dmarcr1997/SoilSpirit/README.md

# SoilSpirit
Code Repo for Arduino/C code for Autonomous Rover
