dmarcr1997/SoilSpirit/Docs/SoilSpiritProtoFinal.pdf

Untitled Gantt Project | Mar 16, 2025 http://

Project manager
Project dates | Feb 19, 2025 - Mar 8, 2025
Completion | 100%
Tasks | 19
Resources | 0

Name | Begin date | End date
MotorControl System | 2/19/25 | 2/26/25
MotorControl: Suspension | 2/19/25 | 2/21/25
Microcontroller Control of motors | 2/24/25 | 2/25/25
MotorControl: Unit Test | 2/25/25 | 2/26/25
Interface creation | 2/26/25 | 2/26/25
Object Detection | 2/25/25 | 2/27/25
Object detection for ESP32 S3 | 2/25/25 | 2/25/25
HTTP Connection to ESP32 | 2/26/25 | 2/27/25
Object Detection: Test | 2/26/25 | 2/27/25
Rover Control and Drive System | 2/27/25 | 3/3/25
Integrate OD into Motor Control | 2/27/25 | 2/27/25
Start/Stop Commands | 2/28/25 | 2/28/25
Ultra sonic sensor emergency stop | 3/3/25 | 3/3/25
Sensor Fusion | 3/4/25 | 3/5/25
Hopper Design | 2/27/25 | 2/27/25
Hopper Build | 2/28/25 | 3/3/25
Tests | 2/24/25 | 3/7/25
Update Website | 2/20/25 | 3/7/25
Update Brief | 2/19/25 | 3/7/25
Untitled Gantt Project | Mar 16, 2025
Tasks | 2

## Gantt Chart

3

Name | Begin date | End date
MotorControl System | 2/19/25 | 2/26/25
MotorControl: Suspension | 2/19/25 | 2/21/25
Microcontroller Control of motors | 2/24/25 | 2/25/25
MotorControl: Unit Test | 2/25/25 | 2/26/25
Interface creation | 2/26/25 | 2/26/25
Object Detection | 2/25/25 | 2/27/25
Object detection for ESP32 S3 | 2/25/25 | 2/25/25
HTTP Connection to ESP32 | 2/26/25 | 2/27/25
Object Detection: Test | 2/26/25 | 2/27/25
Rover Control and Drive System | 2/27/25 | 3/3/25
Integrate OD into Motor Control | 2/27/25 | 2/27/25
Start/Stop Commands | 2/28/25 | 2/28/25
Ultra sonic sensor emergency stop 3/3/25 | 3/3/25
Sensor Fusion | 3/4/25 | 3/5/25
Hopper Design | 2/27/25 | 2/27/25
Hopper Build | 2/28/25 | 3/3/25
Tests | 2/24/25 | 3/7/25
Update Website | 2/20/25 | 3/7/25
Update Brief | 2/19/25 | 3/7/25
February 2025 | March 2025
19 | 20 | 21 | 24 | 25 | 26 | 27 | 28 | 3 | 4 | 5 | 6 | 7 | 10 | 11 | 12 | 13 | 14

Object Detection: Test

## Resources Chart

4
