dmarcr1997/SoilSpirit/Docs/SIPCircuitDesign.png

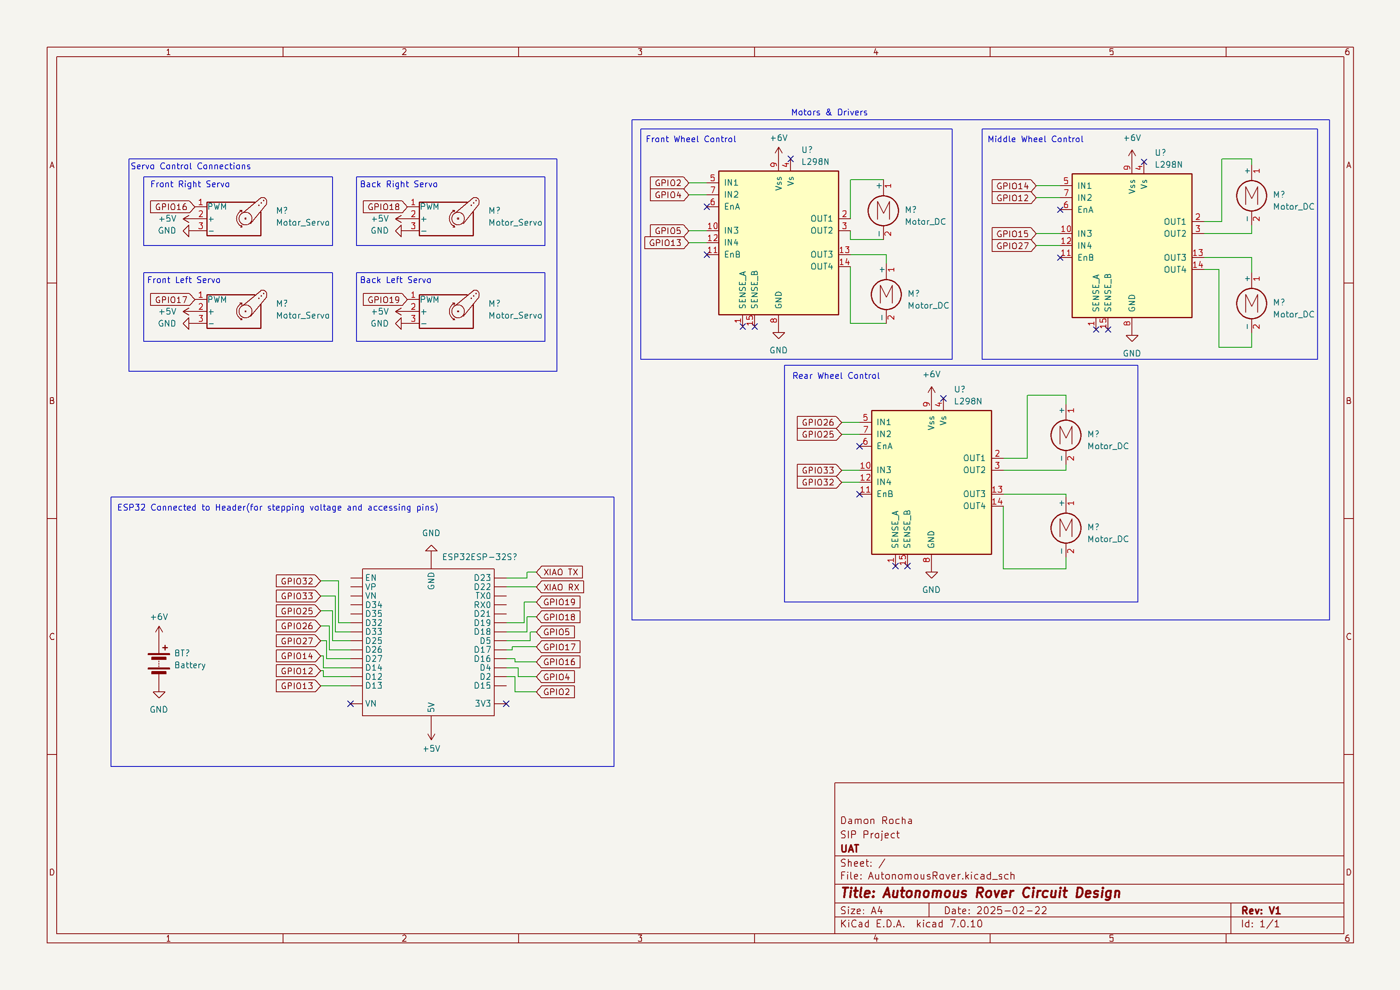
Docs/SIPCircuitDesign.png
