dmarcr1997/SoilSpirit/CAD/V1/DriveSystem/FullDriveShaft.stl

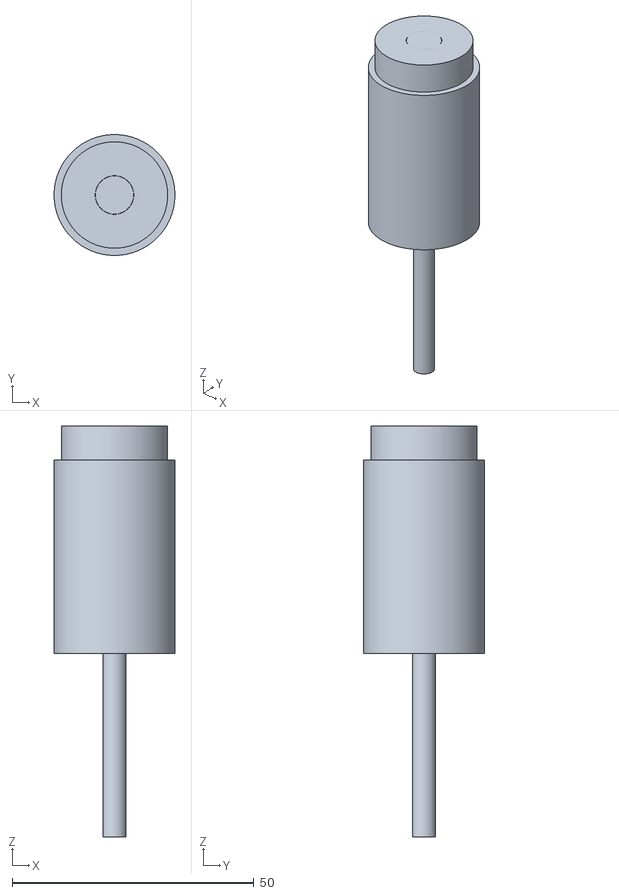
[picture p19: CAD file, 2025-04-02]
CAD/V1/DriveSystem/FullDriveShaft.stl
25.0 x 25.0 x 85.0
