dmarcr1997/SoilSpirit/CAD/V1/DriveSystemV2/MotorHousingFullV2.stl

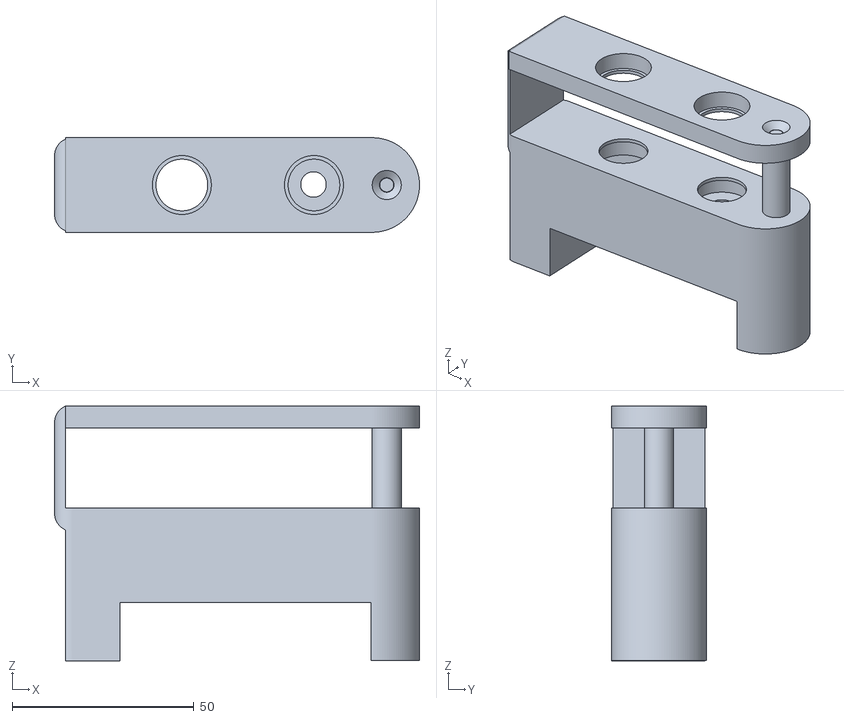
[picture p20: CAD file, 2025-05-12]
CAD/V1/DriveSystemV2/MotorHousingFullV2.stl
100.3 x 26.0 x 70.0
