dmarcr1997/SoilSpirit/CAD/V1/BackAxle.stl

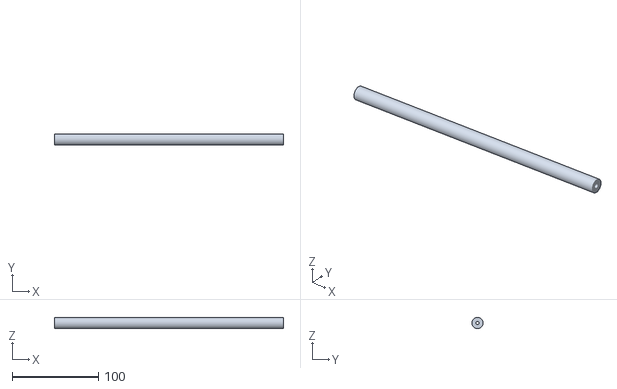
[picture p21: CAD file, 2025-05-12]
CAD/V1/BackAxle.stl
265.0 x 12.9 x 12.9
