dmarcr1997/SoilSpirit/CAD/V1/DriveSystem/GearShaft.stl

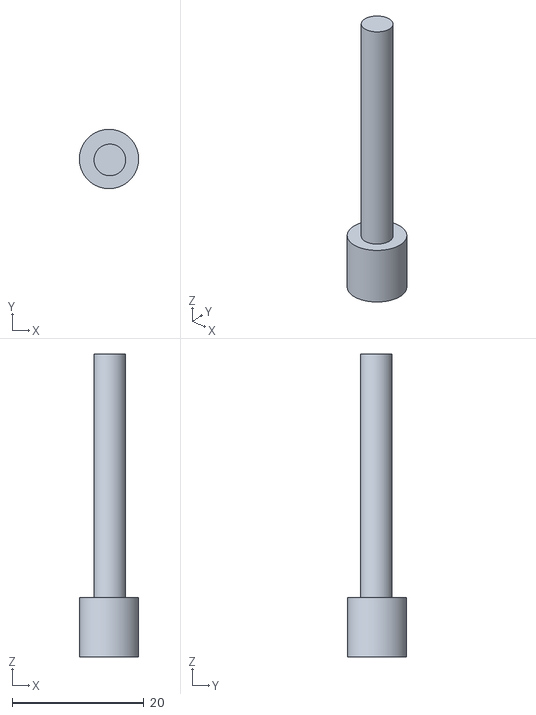
[picture p22: CAD file, 2025-05-12]
CAD/V1/DriveSystem/GearShaft.stl
9.00 x 9.00 x 46.0
