dmarcr1997/SoilSpirit/CAD/V1/DriveSystem/WheelConnector.stl

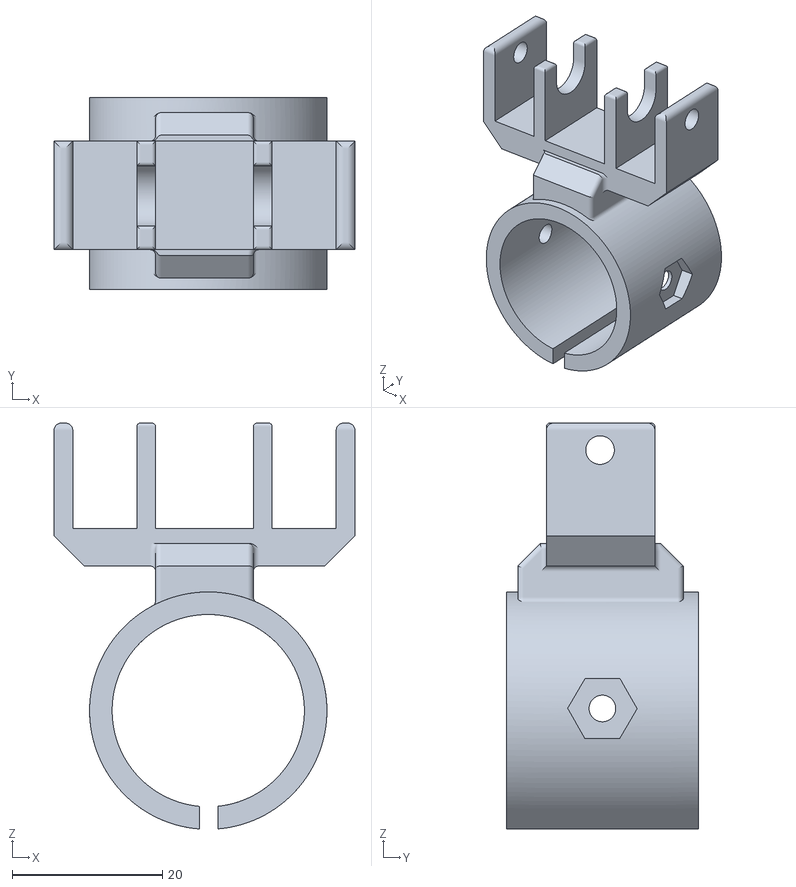
[picture p23: CAD file, 2025-04-02]
CAD/V1/DriveSystem/WheelConnector.stl
40.0 x 25.5 x 54.0
