dmarcr1997/SoilSpirit/CAD/V1/DriveSystemV2/BackSuspension2.stl

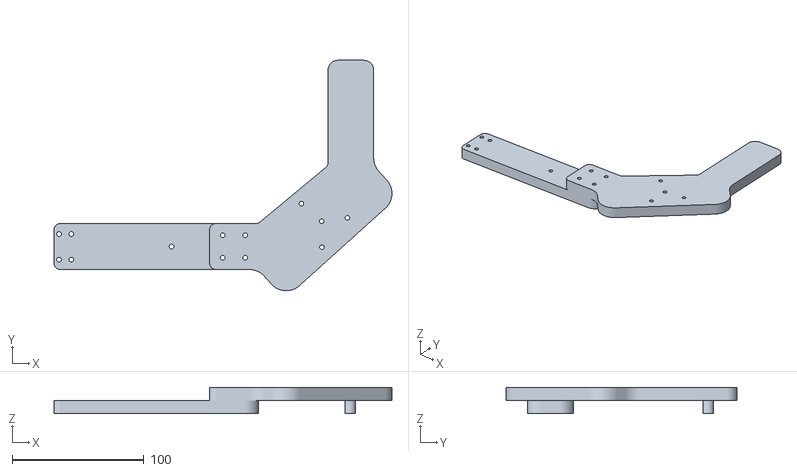
[picture p24: CAD file, 2025-05-12]
CAD/V1/DriveSystemV2/BackSuspension2.stl
256.8 x 175.1 x 20.0
