dmarcr1997/SoilSpirit/CAD/V1/FrontAxle.stl

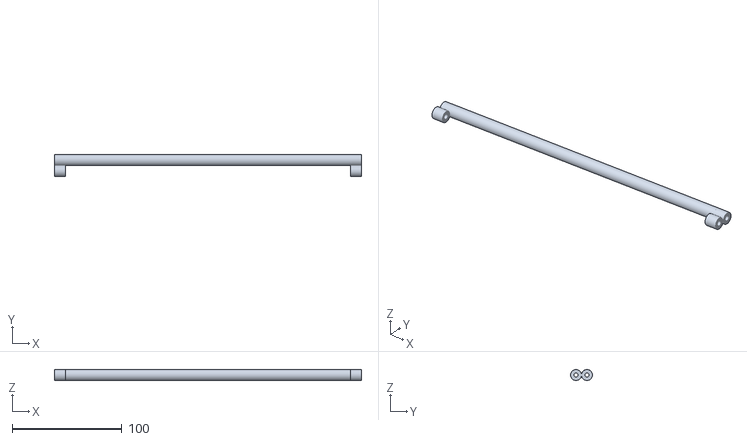
[picture p25: CAD file, 2025-05-12]
CAD/V1/FrontAxle.stl
280.0 x 20.0 x 10.0
