dmarcr1997/SoilSpirit/CAD/V1/HopperTrailer v9.stl

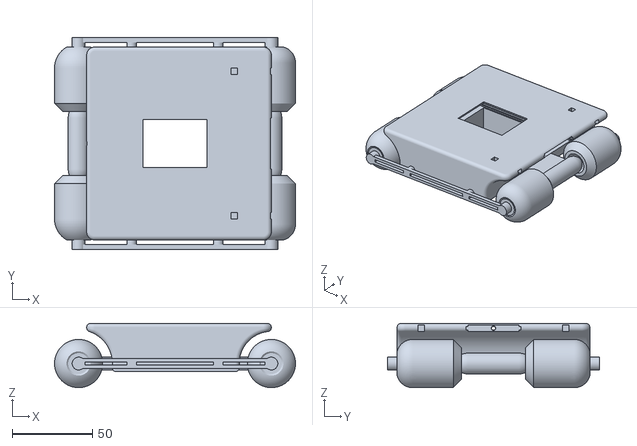
[picture p26: CAD file, 2025-05-12]
CAD/V1/HopperTrailer v9.stl
150.0 x 132.0 x 40.0
