dmarcr1997/SoilSpirit/CAD/V1/DriveSystem/SuspensionConnector.stl

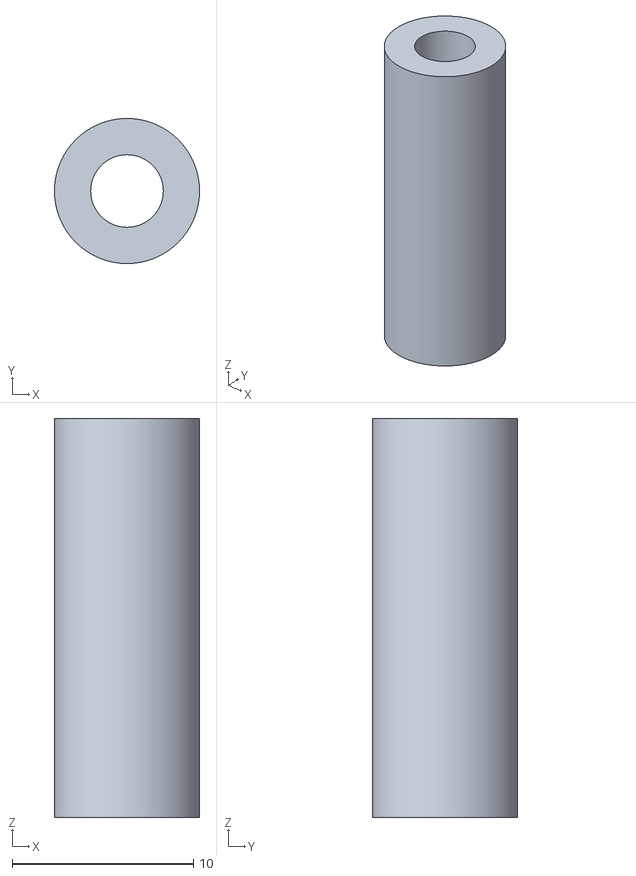
[picture p27: CAD file, 2025-04-02]
CAD/V1/DriveSystem/SuspensionConnector.stl
8.00 x 8.00 x 22.0
