dmarcr1997/SoilSpirit/CAD/V1/DriveSystemV2/BodyConnector.stl

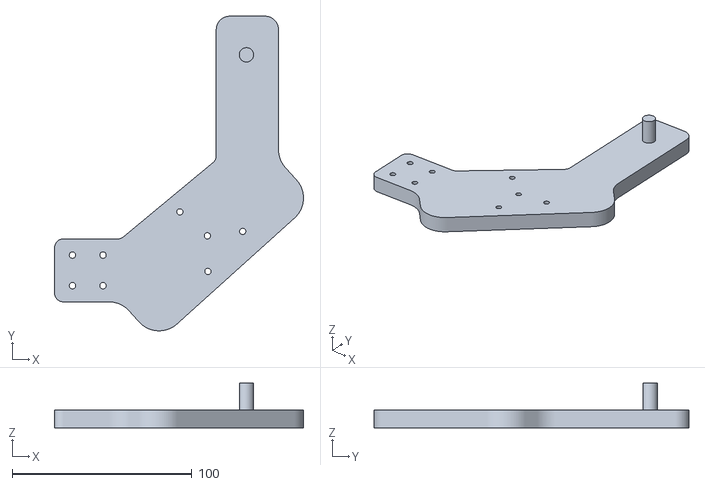
[picture p28: CAD file, 2025-04-02]
CAD/V1/DriveSystemV2/BodyConnector.stl
138.6 x 175.1 x 25.0
