dmarcr1997/SoilSpirit/CAD/V1/DriveSystem/CycloidalGear.stl

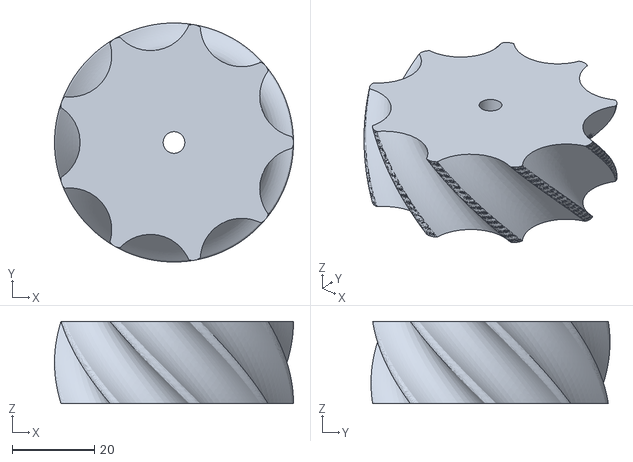
[picture p29: CAD file, 2025-03-26]
CAD/V1/DriveSystem/CycloidalGear.stl
58.2 x 58.2 x 20.0
