dmarcr1997/SoilSpirit/CAD/V1/DriveSystemV2/LowerLegConnector.stl

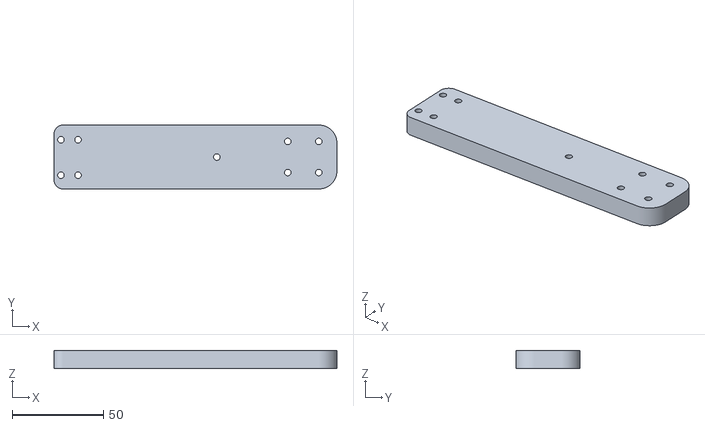
[picture p30: CAD file, 2025-04-02]
CAD/V1/DriveSystemV2/LowerLegConnector.stl
155.2 x 35.1 x 10.0
