dmarcr1997/SoilSpirit/CAD/V1/XiaoCamHolder v2.stl

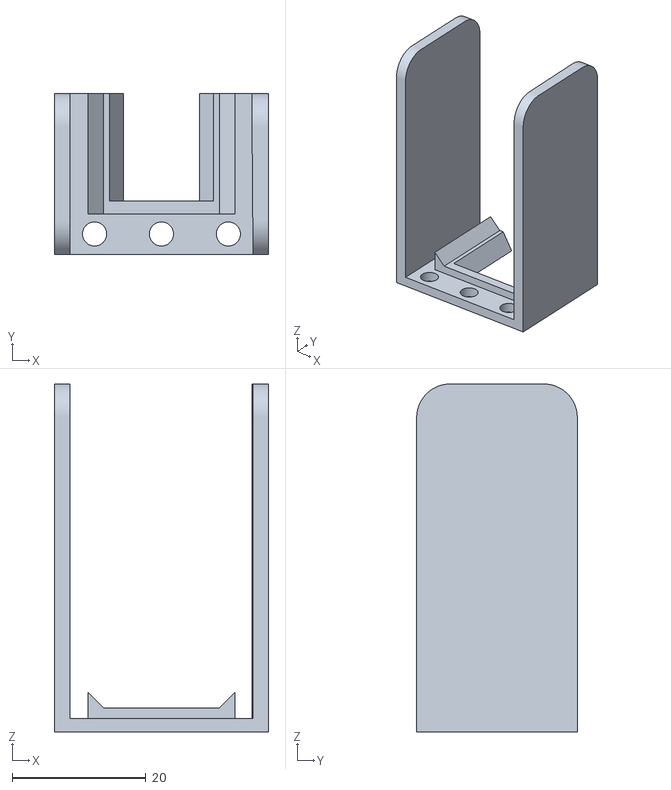
[picture p31: CAD file, 2025-03-10]
CAD/V1/XiaoCamHolder v2.stl
32.0 x 24.0 x 52.0
