dmarcr1997/SoilSpirit/CAD/V1/DriveSystem/Cycloid.stl

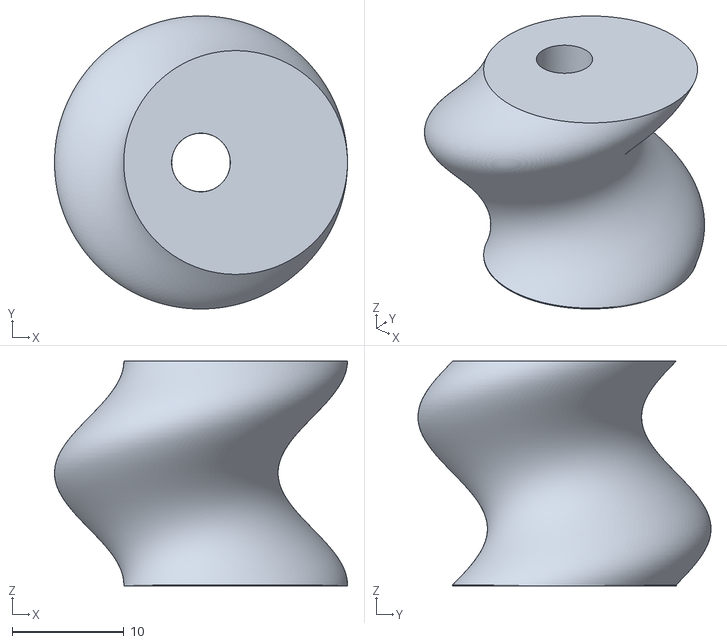
[picture p32: CAD file, 2025-03-26]
CAD/V1/DriveSystem/Cycloid.stl
26.2 x 26.2 x 20.1
