dmarcr1997/SoilSpirit/CAD/V1/DriveSystemV2/SuspensionLow.stl

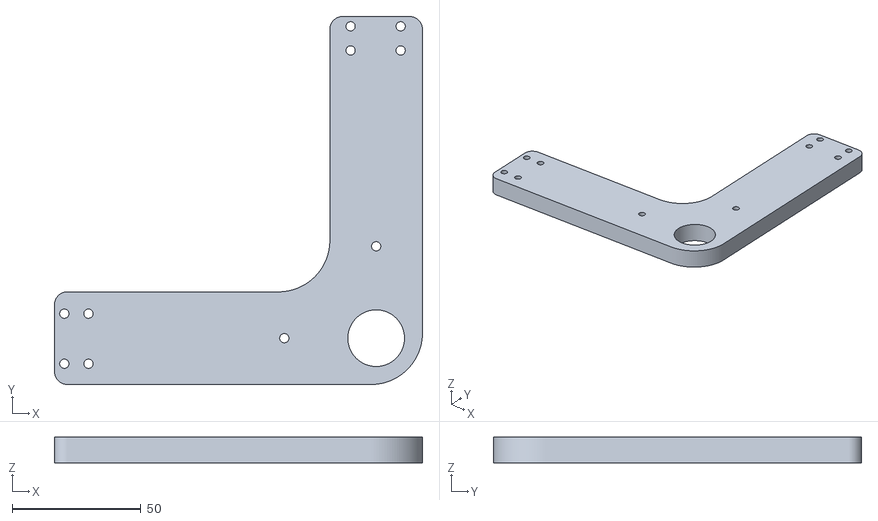
[picture p33: CAD file, 2025-04-02]
CAD/V1/DriveSystemV2/SuspensionLow.stl
143.0 x 143.0 x 10.0
