dmarcr1997/SoilSpirit/CAD/V1/TrailerBody v4.stl

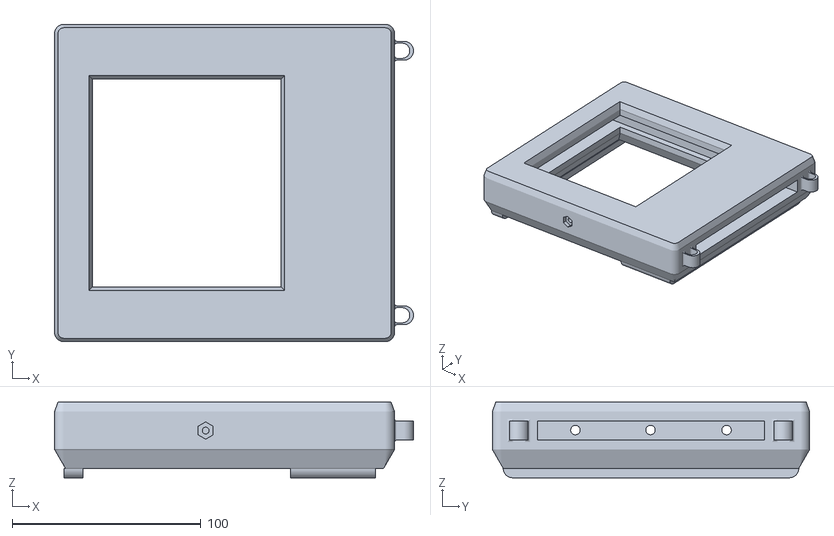
[picture p34: CAD file, 2025-03-10]
CAD/V1/TrailerBody v4.stl
190.0 x 168.0 x 40.0
