dmarcr1997/SoilSpirit/CAD/V1/DriveSystem/CycloidalSpacer.stl

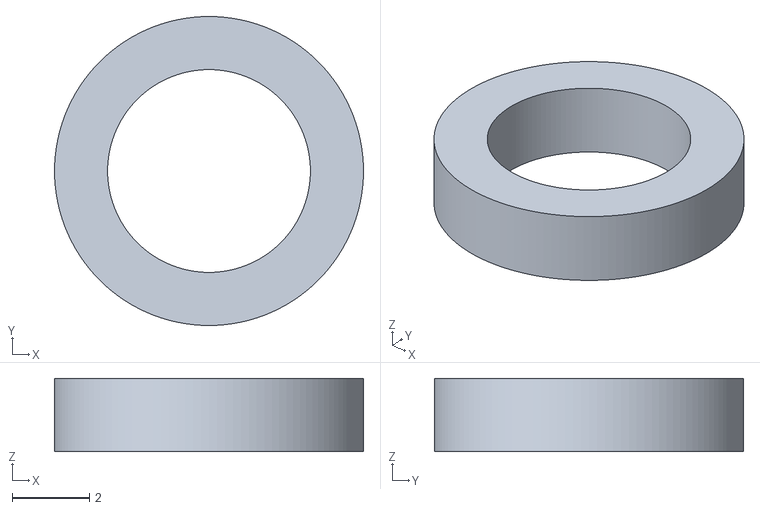
[picture p35: CAD file, 2025-03-26]
CAD/V1/DriveSystem/CycloidalSpacer.stl
8.00 x 8.00 x 1.90
