dmarcr1997/SoilSpirit/CAD/V1/Xiao Sense Case v49 - PETG - Right (Peephole).stl

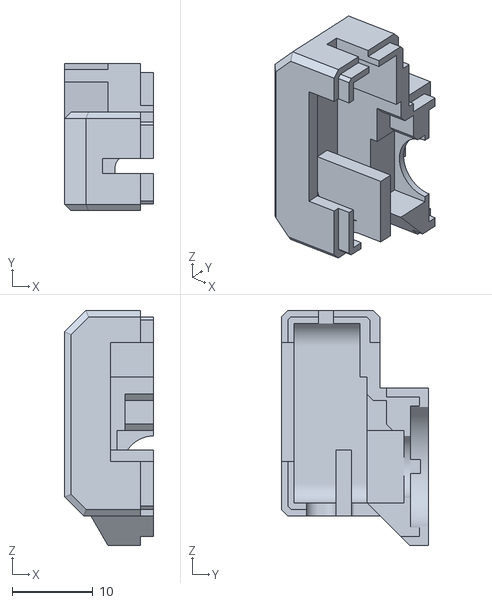
[picture p36: CAD file, 2025-03-10]
CAD/V1/Xiao Sense Case v49 - PETG - Right (Peephole).stl
11.0 x 18.3 x 29.1
