dmarcr1997/SoilSpirit/CAD/V1/DriveSystem/MotorHousingConnector.stl

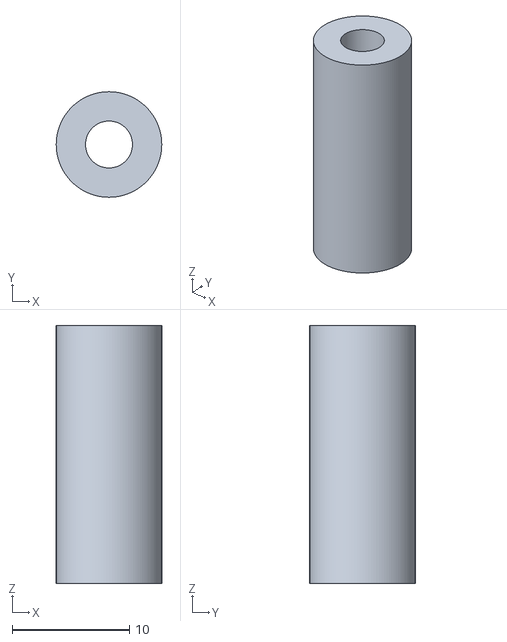
[picture p37: CAD file, 2025-03-26]
CAD/V1/DriveSystem/MotorHousingConnector.stl
9.00 x 9.00 x 22.0
