dmarcr1997/SoilSpirit/CAD/V1/TrailerBodySupp.stl

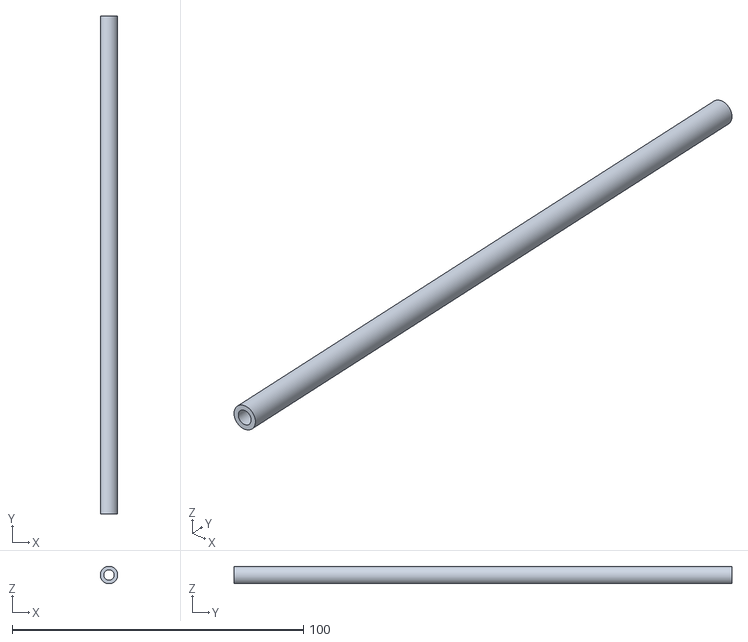
[picture p38: CAD file, 2025-03-10]
CAD/V1/TrailerBodySupp.stl
6.00 x 171.0 x 6.00
