dmarcr1997/SoilSpirit/CAD/V1/DriveSystem/MotorHousing.stl

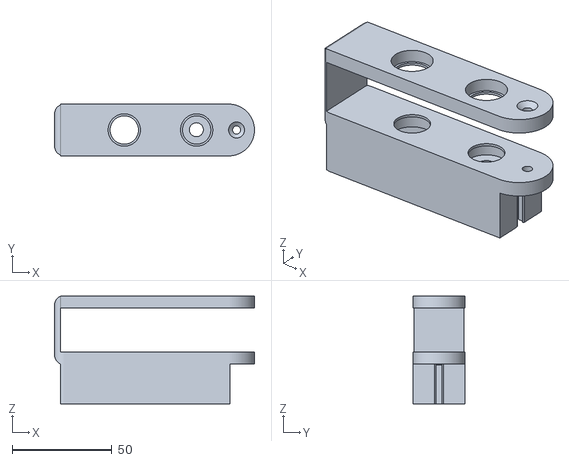
[picture p39: CAD file, 2025-03-26]
CAD/V1/DriveSystem/MotorHousing.stl
100.3 x 26.0 x 54.0
