dmarcr1997/SoilSpirit/CAD/V1/Xiao Sense Case v49 - PETG - Left (Peephole).stl

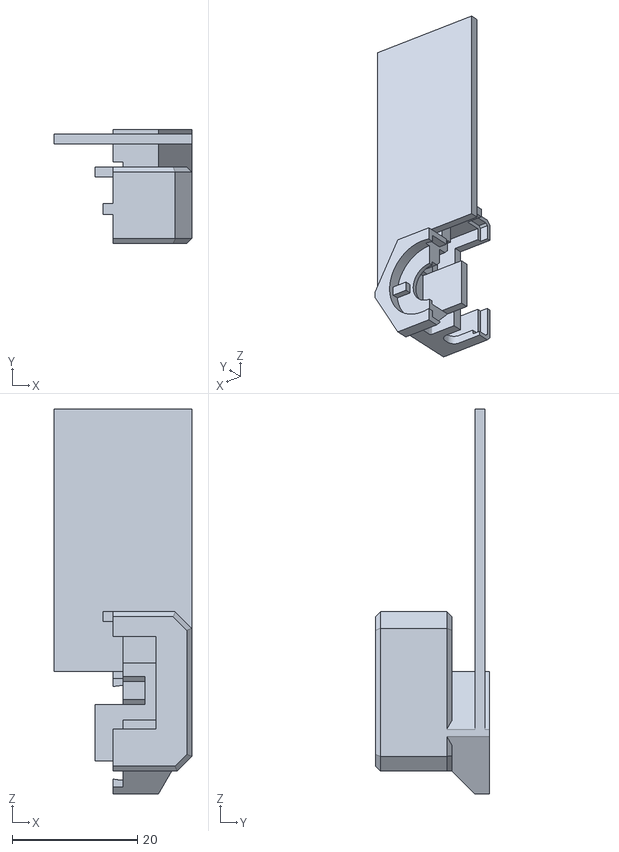
[picture p40: CAD file, 2025-03-10]
CAD/V1/Xiao Sense Case v49 - PETG - Left (Peephole).stl
22.0 x 18.3 x 61.5
