dmarcr1997/SoilSpirit/CAD/V1/TrailerSlide.stl

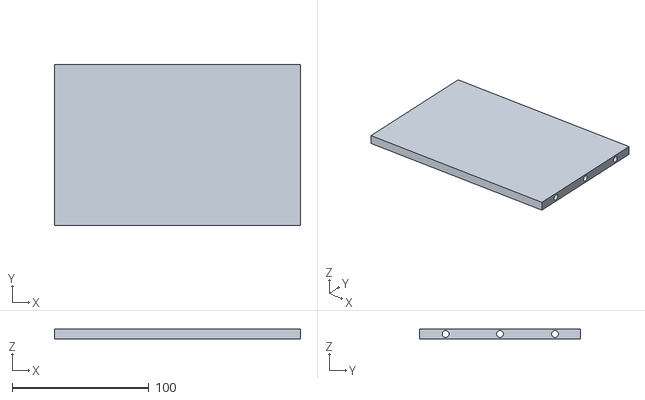
[picture p41: CAD file, 2025-03-03]
CAD/V1/TrailerSlide.stl
180.0 x 117.5 x 7.50
