dmarcr1997/SoilSpirit/CAD/V1/TrailerAxle.stl

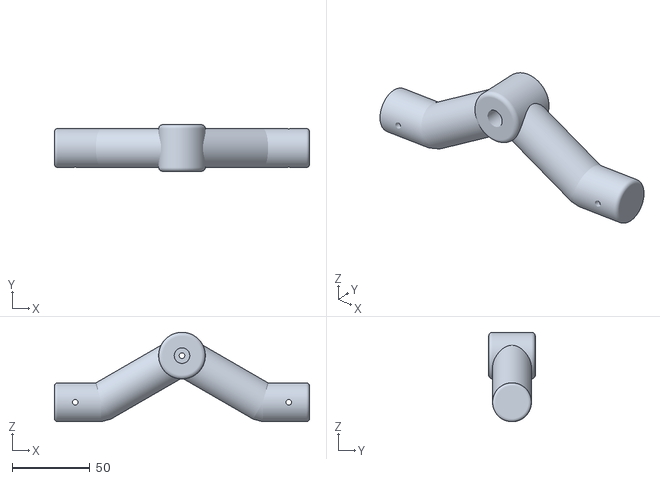
[picture p42: CAD file, 2025-03-03]
CAD/V1/TrailerAxle.stl
163.9 x 30.0 x 57.5
