dmarcr1997/SoilSpirit/CAD/V1/SlideV2.stl

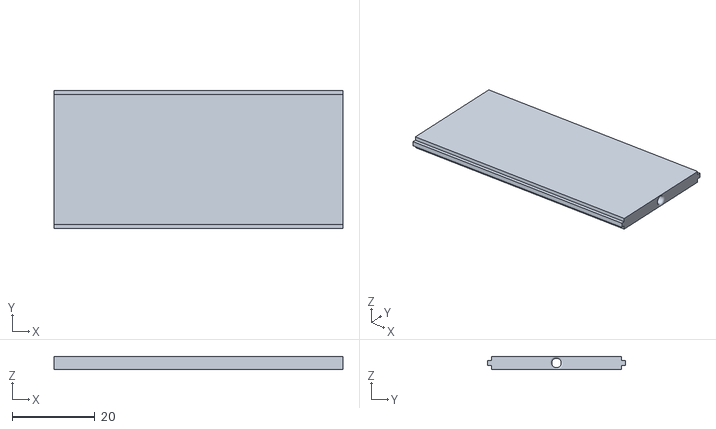
[picture p43: CAD file, 2025-03-01]
CAD/V1/SlideV2.stl
70.0 x 33.5 x 3.25
