dmarcr1997/SoilSpirit/(list of files, cad)

Other CAD files:
CAD/V1/DriveSystemV2/MotorKey.stl
CAD/V1/HopperTrailer v3.stl
CAD/V1/TrailerBody v2.stl
