dmarcr1997/SoilSpirit/CircuitDesign/AutonomousRover/AutonomousRover.kicad_pcb

## KiCad design docs/assets/KiCad/wattson.kicad_sch

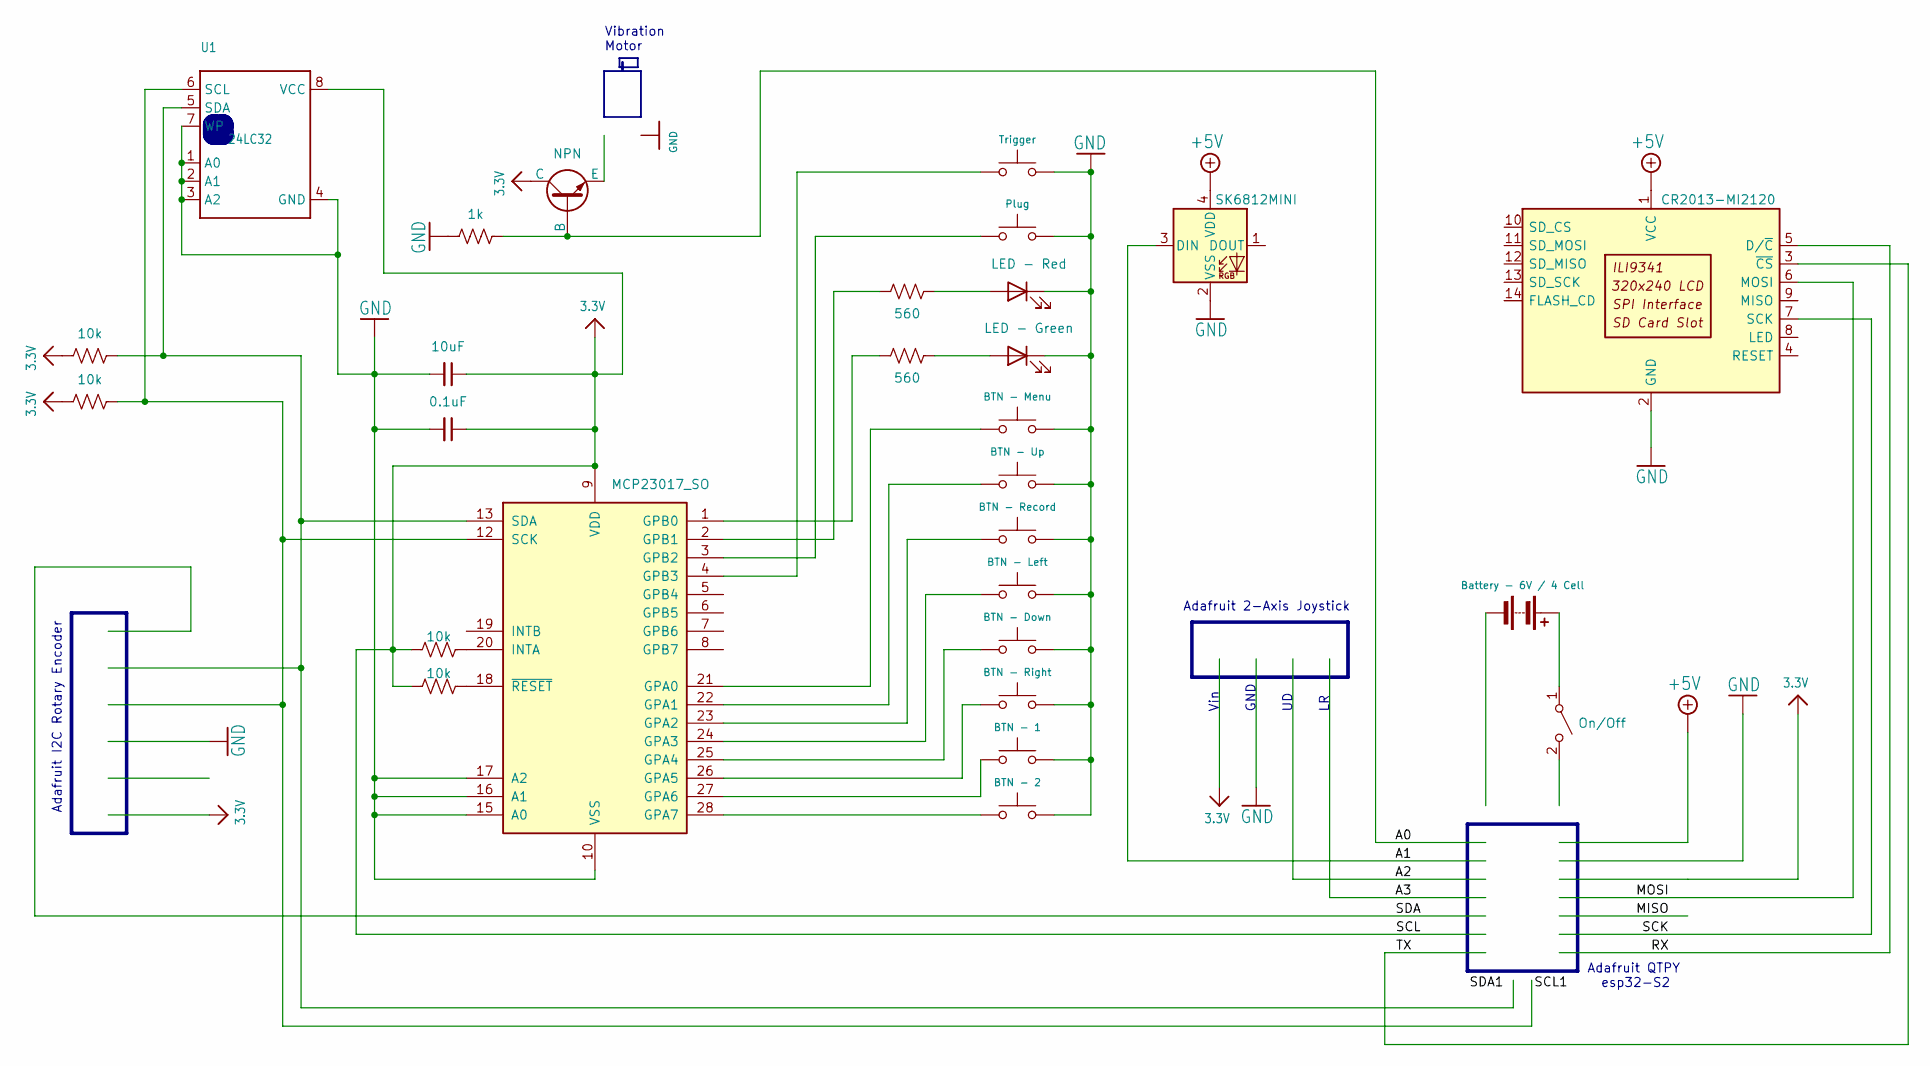
[picture p44: schematic wattson.kicad_sch]

Parts:
BT1: Battery - 6V / 4 Cell
C1: 10uF
C2: 0.1uF
D1: SK6812MINI; LED_SK6812MINI_PLCC4_3.5x3.5mm_P1.75mm
D2: LED - Red
D3: LED - Green
Q2: NPN
R1, R2, R5, R7: 10k
R3, R4: 560
R8: 1k
SW1: BTN - Up
SW2: BTN - Record
SW3: BTN - Left
SW4: BTN - Down
SW5: BTN - Right
SW6: BTN - Menu
SW7: BTN - 1
SW8: BTN - 2
SW9: Trigger
SW10: Plug
SW11: On/Off
U1: 24LC32; SOIC8_150MIL
U2: MCP23017_SO; SOIC-28W_7.5x17.9mm_P1.27mm

Connections:
3.3V: C1.1, C2.1, Q2.1 (C), R1.1, R2.1, R5.1, R7.1, U1.8 (LED), U2.9 (VDD)
+5V: D1.4 (VDD), U1.1 (VCC)
A0: Q2.2 (B), R8.2
A1: D1.3 (DIN)
GND: C1.2, C2.2, D1.2 (VSS), D2.1 (K), D3.1 (K), R8.1, SW1.2, SW2.2, SW3.2, SW4.2, SW5.2, SW6.2, SW7.2, SW8.2, SW9.2, SW10.2, U1.1 (VCC), U1.2 (GND), U1.3 (~CS), U1.4 (RESET), U1.7 (SCK), U2.10 (VSS), U2.15 (A0), U2.16 (A1), U2.17 (A2)
MOSI: U1.6 (MOSI)
unnamed: BT1.1 (+), SW11.1 (A)
unnamed: D2.2 (A), R3.1
unnamed: D3.2 (A), R4.1
unnamed: R1.2, U1.5 (D/~C), U2.13 (SDA)
unnamed: R2.2, U1.6 (MOSI), U2.12 (SCK)
unnamed: R3.2, U2.2 (GPB1)
unnamed: R4.2, U2.1 (GPB0)
unnamed: R5.2, U2.18 (~RESET)
unnamed: R7.2, U2.20 (INTA)
unnamed: SW1.1, U2.22 (GPA1)
unnamed: SW2.1, U2.23 (GPA2)
unnamed: SW3.1, U2.24 (GPA3)
unnamed: SW4.1, U2.25 (GPA4)
unnamed: SW5.1, U2.26 (GPA5)
unnamed: SW6.1, U2.21 (GPA0)
unnamed: SW7.1, U2.27 (GPA6)
unnamed: SW8.1, U2.28 (GPA7)
unnamed: SW9.1, U2.4 (GPB3)
unnamed: SW10.1, U2.3 (GPB2)
RX: U1.5 (D/~C)
SCK: U1.7 (SCK)
TX: U1.3 (~CS)

Notes on the sheet:
Adafruit 2-Axis Joystick
Vibration Motor
Adafruit QTPY esp32-S2
GND
Vin
Adafruit I2C Rotary Encoder
