dmarcr1997/SoilSpirit/XIAOCamera/CameraMCCodeV1/CameraMC/claudeAPI.h

#ifndef CLAUDE_API_H
#define CLAUDE_API_H

#include <Arduino.h>
#include <HTTPClient.h>
#include <ArduinoJson.h>
#include "utils.h"
#include "secrets.h"

String analyzeImageWithClaude(const String& base64Image);
bool sendClaudeRequest(const String& payload, String& result);

#endif //CLAUDE_API_H
