dmarcr1997/SoilSpirit/(commit log)

2025-02-23 Servo and motor testing program, circuit design, and docs
    - Platform.io motor and servo test circuit
    - KiCAD circuit design
    - Saving V2 of docs
    [AutonomousRover.kicad_pcb, AutonomousRover.kicad_sch]
2025-02-23 Full motor drive tests
    - Added rest of motor setup
    - Added test bools for different scenarios
2025-02-26 Modified ESP32 Camera Server code to run analysis on images using CLAUDE LLM
    - Removed object detection code
    - CameraWebServer will most likely change to CameraAnalysis and remove app_httpd.cpp
    - Rover Support beam CAD file
    [partitions.csv]
2025-02-27 Rover support CAD and updates to brief
    - CAD models for rover axles
    - Brief updates
    - Week 2 Gannt
    - Servo + Motor tests for motor driver
2025-02-28 Hopper Trailer, ServoMotor Driver, and CameraMC
    - STL models for Trailer V3/V5
    - Servo and motor Driver code
    - Start of Camera MC code
2025-03-01 Trailer updates and fixed delay time
    - Hopper Trailer V9
    - Fixed delay times for commands
    [SlideV2.stl]
2025-03-02 XIAO Camera server logic
    - Setup .cpp files for apiServer, calls to Claude LLM, and utils
    - Fixed issues with MotorDriverCode
    [CameraMC.ino, claudeAPI.cpp, claudeAPI.h, main.cpp]
2025-03-02 Command Server
    - Created command server due to communication stability between controllers
    - server and dockerfile to create same server that is running on my NAS
    [main.cpp]
2025-03-03 Server driver code
2025-03-03 New Trailer Iteration
    - Previous models were too small and slide didn't work well
    - Rebuilt custom version of front arm rover suspension for trailer
    [TrailerAxle.stl, TrailerBody v2.stl, TrailerSlide.stl]
2025-03-04 Moved camera over to using command server
    - setup connection to NAS
    - removed http endpoint code
2025-03-10 CAD, brief update, and circuit update
    - Trailer CAD final
    - Camera Holder CAD
    - Brief update
    - Circuit schematic update
    - Fixed turning
    - Log reasoning for full_stop from camera
    [AutonomousRover.kicad_sch, TrailerBody v4.stl, TrailerBodySupp.stl, Xiao Sense Case v49 - PETG - Left (Peephole).stl, Xiao Sense Case v49 - PETG - Right (Peephole).stl, XiaoCamHolder v2.stl]
2025-03-11 Start of rover control app and server cors
    - Rover control Next.js app
    - Updated cors policy of server running on NAS
    - New Rover control based on ultrasonic sensor
2025-03-13 Updates to controller, server, and rover driver code
    [AutonomousRover.kicad_sch]
2025-03-14 Fixed continuous drive system for demo
    [main.cpp]
2025-03-16 Updated brief and finalized prototype GANNT
2025-03-26 Beginning of updated gear system
    [Cycloid.stl, CycloidalGear.stl, CycloidalSpacer.stl, DriveShaft.stl, GearShaft.stl, MotorHousing.stl, MotorHousingConnector.stl]
2025-03-28 Updated wiring and started TOF integration
    [AutonomousRover.kicad_sch]
2025-04-02 Drive System V2
    [BodyConnector.stl, DriveShaft.stl, FullDriveShaft.stl, LowerLegConnector.stl, SuspensionConnector.stl, SuspensionLow.stl, WheelConnector.stl]
2025-05-12 Directory clean up, removed servo, US Sensor. and middle motor code, and TOF sensor integration with OD
    [AutonomousRover.kicad_sch, BackAxle.stl, BackSuspension2.stl, BodyConnector.stl, Cycloid.stl, CycloidalGear.stl, CycloidalSpacer.stl, FrontAxle.stl]
2025-05-13 Fixed LED bug and swapped left/right directions
    [MotorDriver.cpp, main.cpp]
